edrixon/binary-clock/data/pcb-small.jpg

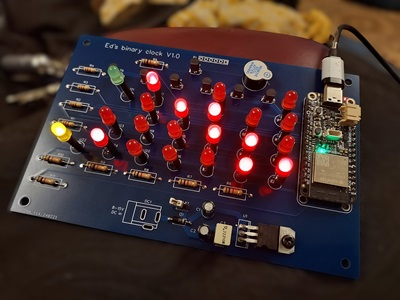
data/pcb-small.jpg
