edrixon/binary-clock/doc/schematic.pdf

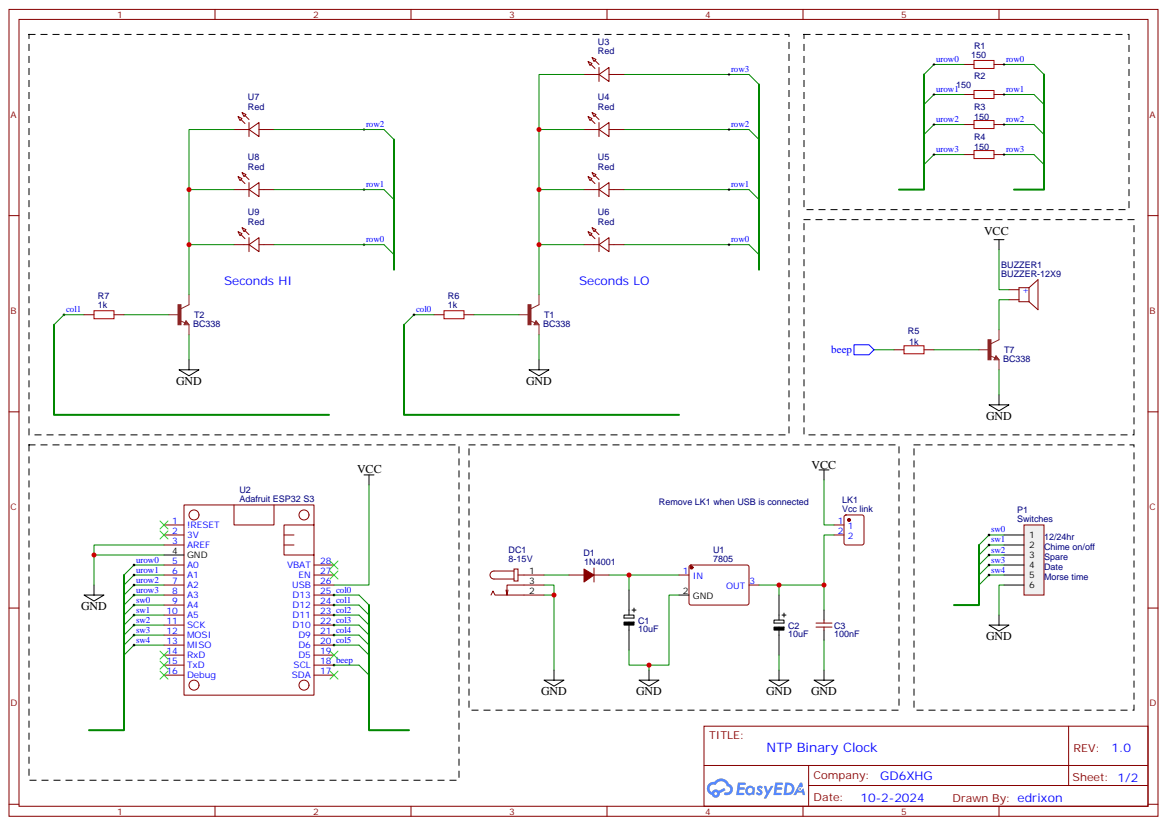
[picture p6: page 1]

Remove LK1 when USB is connected

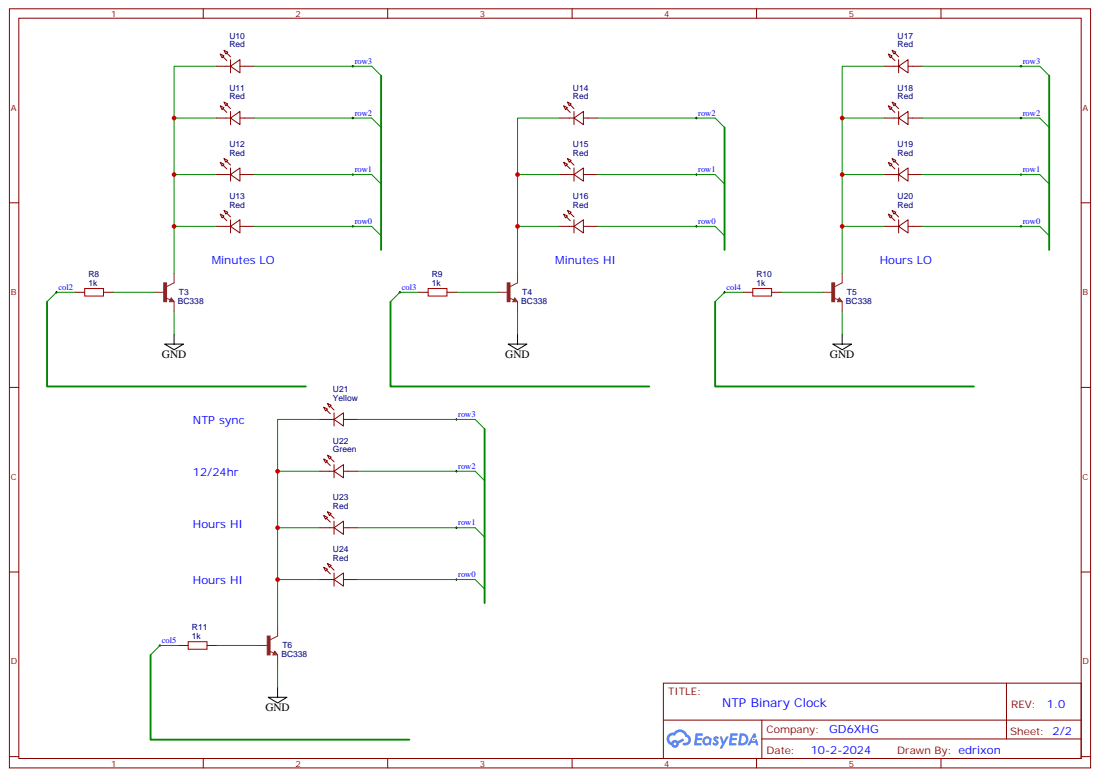
[picture p7: page 2]
